2788west/cerusbot/(list of files, drawings)

Other design files:
encoders/images/arduino_mcp_eight_encoders.fzz
encoders/images/arduino_mcp_one_encoder.fzz
