2788west/cerusbot/(commit log)

2020-09-19 add encoder code
    [arduino_mcp_eight_encoders.fzz, arduino_mcp_one_encoder.fzz]
2020-09-19 add motor driver
2020-09-21 Add arduino code
2020-10-02 add arduino and jetson code
2020-10-02 update arduino and jetson code
2020-11-30 Update jetson and arduino code
2020-12-10 add BOM
    [BOM.csv]
2020-12-10 add 3D printing files
2020-12-12 Update PID
